OpenAirCgn/noisemeter/Noisemeter_BOM.ods

 |  |  |  |  |  |  |  |  |  |  |  | Units
Non-listed parts are not populated |  |  |  |  |  |  |  |  |  |  |  | 11
Qty | Reference(s) | Value | Footprint | Manuf | Number | Source | Source # | Source € | Source @ | Remarks | Cost/unit | Needed | Avail | Needed | Cost/all | Order | Cost order
 | Resistors
9 | R1, R2, R15, R16, R17, R18, R19, R20, R21 | 0/DNP | 0603 |  |  | avail |  |  |  |  | 0 | 99 | 999 | 0 | 0 |  | 0
3 | R6, R7, R8 | 33 | 0603 |  |  | avail |  |  |  |  | 0 | 33 | 999 | 0 | 0 |  | 0
1 | R22 | 220 | 0603 |  |  | avail |  |  |  |  | 0 | 11 | 999 | 0 | 0 |  | 0
1 | R9 | 2K2 | 0603 |  |  | avail |  |  |  |  | 0 | 11 | 999 | 0 | 0 |  | 0
5 | R3, R4, R10, R11, R13 | 10K | 0603 |  |  | avail |  |  |  |  | 0 | 55 | 999 | 0 | 0 |  | 0
2 | R14, R12 | 22K | 0603 | Stackpole | RMCF0603FT22K0TR-ND | DK | RMCF0603FT22K0TR-ND | 0,00179 | 5000 | reel | 0,00358 | 22 | 0 | 22 | 0,03938 | 5000 | 8,95 | incl Openair
1 | R12 – is 22K now | 47K | 0603 |  |  | avail(49.9K)
1 | R5 | 100K | 0603 |  |  | avail |  |  |  |  | 0 | 11 | 999 | 0 | 0 |  | 0
 | Capacitors
1 | C10 | 10p/DNP | 0603 |  |  |  |  |  |  |  | 0 | 11 |  | 11 | 0 |  | 0
2 | C4, C5 | 18p | 0603 |  |  | avail |  |  |  |  | 0 | 22 | 999 | 0 | 0 |  | 0
1 | C12 | 47p | 0603 | Würth | 885012006002 | DK | 732-7746-1-ND | 0,0217 | 100 |  | 0,0217 | 11 | 90 | 0 | 0,2387 |  | 0
1 | C9 | 100p | 0603 | Würth | 885012006057 | DK | 732-7799-1-ND | 0,0201 | 100 |  | 0,0201 | 11 | 90 | 0 | 0,2211 |  | 0
1 | C20 | 10n | 0603 |  |  | avail
5 | C2, C6, C7, C8, C13 | 100n | 0603 |  |  | avail |  |  |  |  | 0 | 55 | 999 | 0 | 0 |  | 0
5 | C1, C3, C11, C14, C21 | 1u | 0603 |  |  | avail |  |  |  |  | 0 | 55 | 999 | 0 | 0 |  | 0
2 | C15, C19 | 4u7 | 0603 | Samsung | CL10A475MQ8NNNC | DK | 1276-1907-1-ND | 0,0244 | 100 |  | 0,0488 | 22 | 80 | 0 | 0,5368 |  | 0
2 | C17, C18 | 10u | 0603 | AVX | 0603ZD106KAT2A | DK | 478-10766-1-ND | 0,104 | 10 |  | 0,208 | 22 | 90 | 0 | 2,288 |  | 0 | included in Quadsense
 | Inductors
1 | L1 | FERRITE | 0603 | Samsung | CIC10P471NC | DK | 1276-6358-1-ND | 0,024 | 10 |  | 0,024 | 11 |  | 11 | 0,264 |  | 0 | included in Openair
1 | L2 | 22u 2-3Ω | 0603 | TDK | MLZ1608M220WT000 | DK | 445-181372-1-ND | 0,139 | 10 |  | 0,139 | 11 |  | 11 | 1,529 | 20 | 2,78
 | Semiconductors
1 | LED1 | LED | 0603 | Würth | 150060RS75000 | DK | 732-4978-1-ND | 0,13 | 1 |  | 0,13 | 11 | 99 | 0 | 1,43 |  | 0 | included in Openair
1 | X1 | Crystal 32.768kHz 12.5p | 1206 | TXC | 9HT10-32.768KAZF-T | avail |  |  |  |  | 0 | 11 | 11 | 0
 | ICs
1 | IC1 | MCP1801 | SOT23-5 | Microchip | MCP1801T-3302I/OT | DK | MCP1801T-3302I/OTCT-ND | 0,38 | 1 |  | 0,38 | 11 | 2 | 9 | 4,18 | 10 | 3,8
1 | IC2 | STM32L433 | QFN-48-0.5-EP | ST Micro | STM32L433CBU6 | DK | 497-17962-ND | 4,38 | 1 |  | 4,38 | 11 | 4 | 7 | 48,18 | 10 | 43,8
1 | IC3 | OPA376 | SOT23-5 | TI | OPA376AIDBVR | DK | 296-39130-1-ND | 1,52 | 1 |  | 1,52 | 11 | 4 | 7 | 16,72 | 10 | 15,2
1 | IC3 | TLV316 | SOT23-5 | TI | TLV316IDBVT | DK | 296-43939-1-ND | 0,408 | 10 |  | 0,408 | 11 | 6 | 5 | 4,488 |  | 0
1 | MIC1 | SPH0645LM4H-B | SPH0645LM4H-B | Knowles | SPH0645LM4H-B | DK | 423-1405-1-ND | 2,6 | 1 |  | 2,6 | 11 | 4 | 7 | 28,6 | 10 | 26
 | Mechanical
2 | B1, B2 | RST, PROG | PTS830 | C&K | PTS830GM140 SMTR LFS | DK | CKN10587CT-ND | 0,434 | 10 |  | 0,868 | 22 | 99 | 0 | 9,548 |  | 0 | included in Openair
1 | P1 | USB | USB-MICRO-B | Amphenol | 10104110-0001LF | DK | 609-4052-1-ND | 0,582 | 10 |  | 0,582 | 11 | 99 | 0 | 6,402 |  | 0 | included in Openair
1 | P4 | MOD | everykey:HEADER-1x08-1.27-ZZ-POL | TE | 215570-8 | DK | A111111CT-ND | 0,56 | 10 |  | 0,56 | 11 | 99 | 0 | 6,16 |  | 0 | DNP
1 | Plug for P4 |  |  | TE | 215083-8 | DK | A111108CT-ND | 0,614 | 10 |  | 0,614 | 11 |  | 11 | 6,754 |  | 0 | included in Quadsense
1 | MIC | Electret microphone |  | PUI audio | AOM-5024L-HD-R | DK | 668-1596-ND | 2,85 | 1 |  | 2,85 | 11 | 4 | 7 | 31,35 | 5 | 14,25
 |  |  |  |  |  |  |  |  |  |  | 15,35718 |  |  |  | 168,92898 |  | 114,78
