OpenAirCgn/noisemeter/Noisemeter.kicad_pcb

## KiCad design Noisemeter.kicad_pcb (2019-08-29)

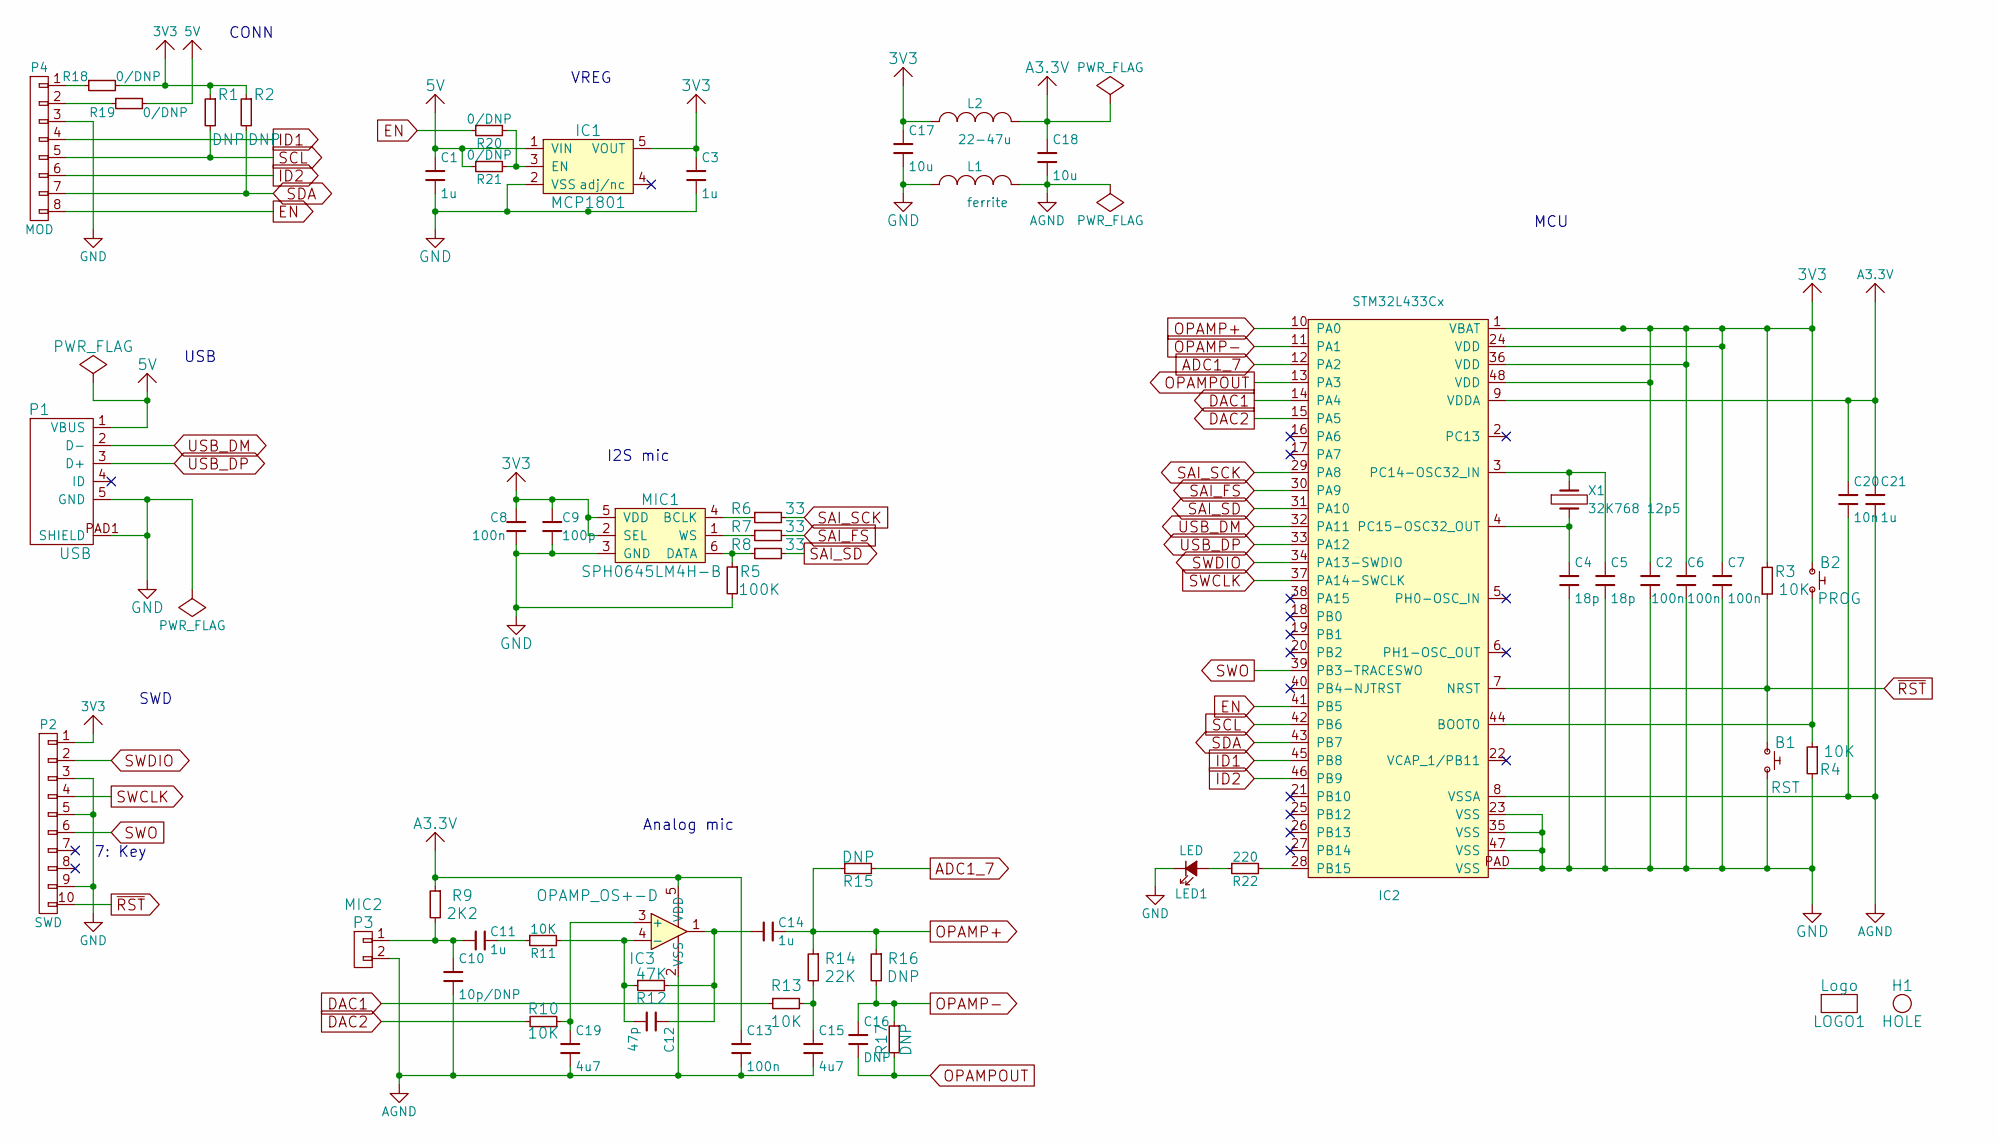
[picture p1: schematic Noisemeter.sch]

Parts:
B1: RST; CK-PTS830
B2: PROG; CK-PTS830
C1, C3, C11, C14, C21: 1u; 0603
C2, C6, C7, C8, C13: 100n; 0603
C4, C5: 18p; 0603
C9: 100p; 0603
C10: 10p/DNP; 0603
C12: 47p; 0603
C15, C19: 4u7; 0603
C16: DNP; 0603
C17, C18: 10u; 0603
C20: 10n; 0603
H1: HOLE; HOLE-3.2
IC1: MCP1801; SOT23-5
IC2: STM32L433Cx
IC3: OPAMP_OS+-D; SOT23-5
L1: ferrite; 0603
L2: 22-47u; 0603
LED1: LED; 0603-POLAR
LOGO1: Logo
MIC1: SPH0645LM4H-B; SPH0645LM4H-B-ext
P1: USB; USB-MICRO-B
P2: SWD; HEADER-2x05-1.27
P3: MIC2; HEADER-1x02-2.54
P4: MOD; HEADER-1x08-1.27-ZZ-POL
R1, R2, R15, R16, R17: DNP; 0603
R3, R4, R10, R11, R13: 10K; 0603
R5: 100K; 0603
R6, R7, R8: 33; 0603
R9: 2K2; 0603
R12: 47K; 0603
R14: 22K; 0603
R18, R19, R20, R21: 0/DNP; 0603
R22: 220; 0603
X1: 32K768 12p5; 1206

Connections:
3V3: B2.1, C2.1, C3.1, C6.1, C7.1, C8.1, C9.1, C17.1, IC1.5 (VOUT), IC2.1 (VBAT), IC2.24 (VDD), IC2.36 (VDD), IC2.48 (VDD), L2.1, MIC1.2 (SEL), MIC1.5 (VDD), P2.1, R1.1, R2.1, R3.2, R18.2
ADC1_7: IC2.12 (PA2), R15.2
DAC1: IC2.14 (PA4), R13.1
DAC2: IC2.15 (PA5), R10.2
EN: IC2.41 (PB5), P4.8, R20.1
ID1: IC2.45 (PB8), P4.4
ID2: IC2.46 (PB9), P4.6
unnamed: B2.2, IC2.44 (BOOT0), R4.1
unnamed: C4.1, IC2.4 (PC15-OSC32_OUT), X1.2
unnamed: C5.1, IC2.3 (PC14-OSC32_IN), X1.1
unnamed: C10.1, C11.2, P3.1, R9.2
unnamed: C11.1, R11.1
unnamed: C12.1, C14.2, IC3.1, R12.2
unnamed: C12.2, IC3.4 (-), R11.2, R12.1
unnamed: C15.1, R13.2, R14.2
unnamed: C19.1, IC3.3 (+), R10.1
unnamed: IC1.3 (EN), R20.2, R21.2
unnamed: IC2.28 (PB15), R22.2
unnamed: LED1.A, R22.1
unnamed: MIC1.1 (WS), R7.1
unnamed: MIC1.4 (BCLK), R6.1
unnamed: MIC1.6 (DATA), R5.1, R8.1
unnamed: P4.1, R18.1
unnamed: P4.2, R19.1
OPAMP+: C14.1, IC2.10 (PA0), R14.1, R15.1, R16.1
OPAMP-: C16.1, IC2.11 (PA1), R16.2, R17.1
OPAMPOUT: C16.2, IC2.13 (PA3), R17.2
SAI_FS: IC2.30 (PA9), R7.2
SAI_SCK: IC2.29 (PA8), R6.2
SAI_SD: IC2.31 (PA10), R8.2
SCL: IC2.42 (PB6), P4.5, R1.2
SDA: IC2.43 (PB7), P4.7, R2.2
SWCLK: IC2.37 (PA14-SWCLK), P2.4
SWDIO: IC2.34 (PA13-SWDIO), P2.2
SWO: IC2.39 (PB3-TRACESWO), P2.6
USB_DM: IC2.32 (PA11), P1.2 (D-)
USB_DP: IC2.33 (PA12), P1.3 (D+)
~RST: B1.1, IC2.7 (NRST), P2.10, R3.1

Notes on the sheet:
I2S mic
VREG
USB
CONN
Analog mic
7: Key
SWD
MCU

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
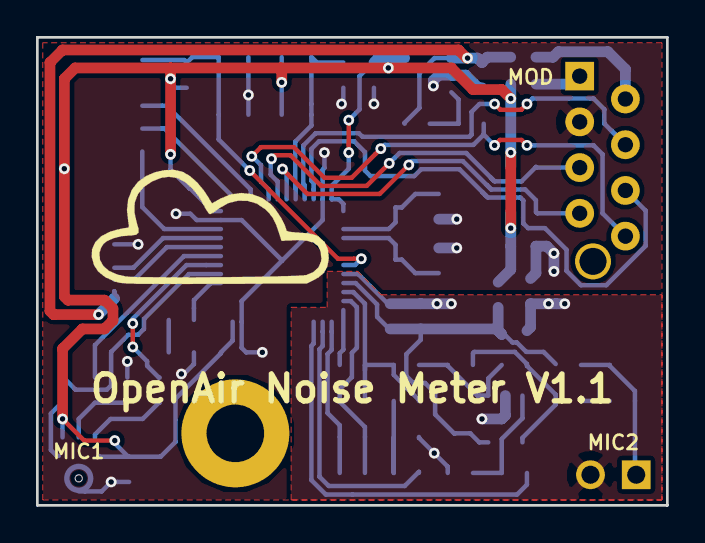
[picture p2: board Noisemeter.kicad_pcb from above]

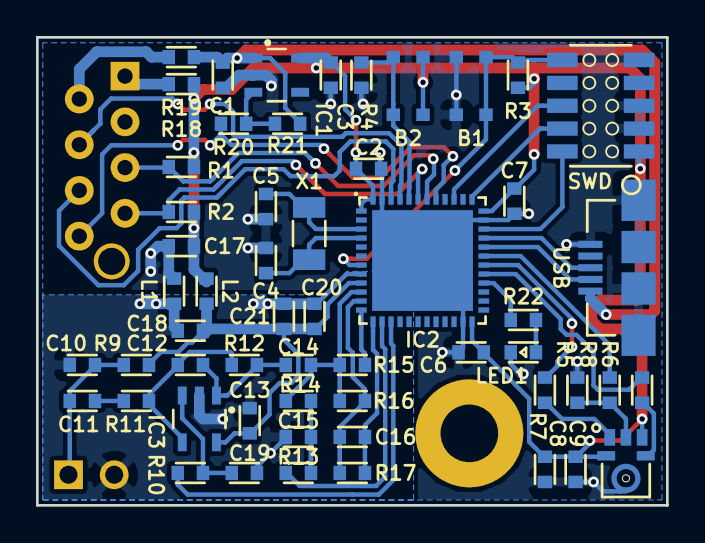
[picture p3: board Noisemeter.kicad_pcb from below]

Board: 2 copper layers, 35.0 x 26.0 mm, 59 parts (55 on the bottom side), 42 nets.
