OpenAirCgn/noisemeter/(commit log)

2019-01-24 Initial version
    [Noisemeter.kicad_pcb, Noisemeter.sch]
2019-06-06 Added BOM
    [Noisemeter BOM.ods]
2019-06-13 Version 1.0
    [Noisemeter BOM.ods, Noisemeter.sch]
2019-06-14 Fixed analog power supply
    [Noisemeter.kicad_pcb, Noisemeter.sch]
2019-08-29 minor changes, BOM rename
    [Noisemeter BOM.ods, Noisemeter.kicad_pcb, Noisemeter.sch, Noisemeter_BOM.ods]
